lms-osz/wind/static/img/project/pi_installed_scaled.png

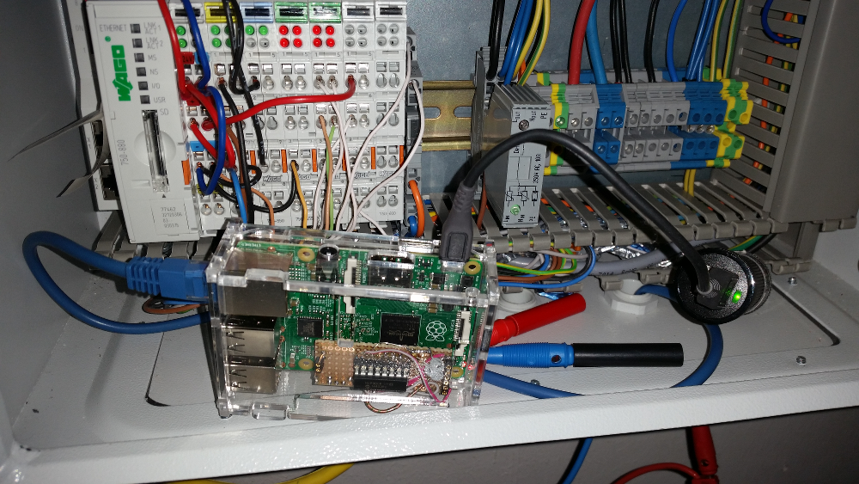
static/img/project/pi_installed_scaled.png
