lms-osz/wind/static/img/project/pi.png

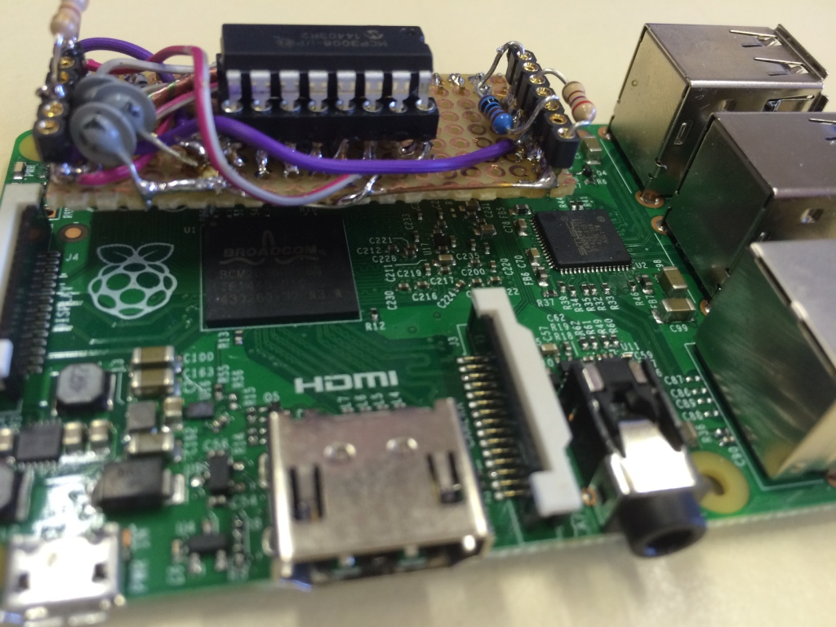
static/img/project/pi.png
