lms-osz/wind/schematics/README

Proudly made with KiCAD and the TinkerForge Libary:
https://github.com/Tinkerforge/kicad-libraries/blob/master/tinkerforge.lib
