lms-osz/wind/schematics/theorie.odt

A`=`1,0{m^2} ~~~~~~~~~~~~~%rho`=`1,205kg over m^{3} newline
C_Betz`=`{16 over 27}(ca. 60"%") ~~~~~~~~v`=`14{m over s} newline
P_{an~(Hersteller bei `14{m over s} )}`=` 250W ~
newline
P_ein `=` C_Betz {`cdot` {{1 over 2} `cdot` %rho `cdot` A `cdot` (v_wind)^{3}} overbrace
P_wind} newline P(14{m over s}) `=` {16 over 27}` cdot `{1 over 2}`cdot `1,205kg over m^{3} `cdot` 1,0{m^2} `cdot` (14{m over s})^{3} newline P(14{m over s})`=`{0,375 {kg over m}}`cdot` (14{m over s})^{3}`=` 979,6 W newline
%eta`=` P_an over P_ein `=` {250W} over {979,6 W} `=` 25,5"%"

Wirkungsgradberechnung

bei 14 m/s Windgeschwindigkeit und der Leistung 250W des Hersteller

Für die Berechnung des Wirkungsgrad braucht man die aktuelle Windgeschwindigkeit und aktuelle elektrische Leistung, welche sich aus der Stromstärke (I) und der Spannung (U) zusammensetzt.

Das Betz'sche Gesetz besagt, dass eine Windkraftanlage maximal 16/27 (knapp 60 Prozent) jener mechanischen Leistung, die der Wind ohne den bremsenden Rotor durch dessen Projektionsfläche transportiert, in Nutzleistung umwandeln kann. (von Wikipedia am 1.5.15 aufgerufen)

# Windkraftanlagen

Twister T 300

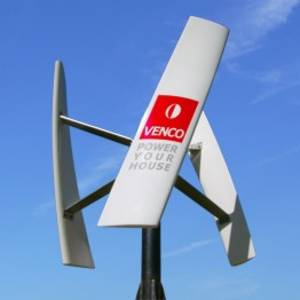
[picture p3: figure]

(http://www.fiber-tech.de/cms/index.php?eID=tx_cms_showpic&md5=b855fdd886baf51e2a2384f334ff9e43a7b020d7)

Der Twister T 300 wird eingesetzt von Instituten und öffentlichen Trägern, Forschungseinrichtungen sowie privaten Nutzern.

Der VENCO-Twister-300-T wurde so konzipiert, dass er bei einer Windgeschwindigkeit von ca. 3,0 m/s andreht. Ab einer Windgeschwindigkeit von 3,5 m/s wird Strom produziert. Durch seinen speziellen Aufbau arbeitet der VENCO-Twister-300-T absolut geräuschlos.

Seine Konstruktion ist robust und ohne verschleißende Bauteile. Er ist wartungsfrei und arbeitet auch unter extremen Bedingungen zuverlässig.

Das Gewicht mit Minimast beträgt ca. 52kg.

Technische Daten Rotor

Rotortyp | Vertikalachsen-Rotor
Nennleistung | 300W
Nennwindgeschwindigkeit | 14 m/s
max. Leistung | 250W (300 W)
Einschaltgeschwindigkeit | 3,5 m/s
Abschaltgeschwindigkeit | 25 m/S
Windnachführung | nicht erforderlich
Drehzahlregelung | elektronisch
Überlebenswindgeschwindigkeit | 50 m/s
Rotordurchmesser | 1,0 m
Blatthöhe | 1,0 m
überstrichene Fläche | 1,0 m²
Getriebetyp | getriebelos
Bremsanlagen | Generatorkurzschluss

Generator

Generatortyp | 3 Phasen Synchrongenerator, permanenterregt
Spannung | 0 bis 70 V DC
Elektronik | Überdrehzahl- u. Sicherheitscontroller
Laderegler | 10 / 24 V max. Ladestrom 25 A

Material

Streben | Edelstahl
Generatorgehäuse | Edelstahl
Rotorblätter | Glasfaser- u. Kohlefaser-verstärkter Kunststoff
