lms-osz/wind/static/pdf/theory.pdf

## Wirkungsgradberechnung

bei 14 m/s Windgeschwindigkeit und der Leistung 250W des Hersteller

Für die Berechnung des Wirkungsgrad braucht man die aktuelle Windgeschwindigkeit und aktuelle elektrische Leistung, welche sich aus der Stromstärke (I) und der Spannung (U) zusammensetzt.

Das Betz'sche Gesetz besagt, dass eine Windkraftanlage maximal 16/27 (knapp 60 Prozent) jener mechanischen Leistung, die der Wind ohne den bremsenden Rotor durch dessen Projektionsfläche transportiert, in Nutzleistung umwandeln kann. (von Wikipedia am 1.5.15 aufgerufen)

A = 1,0m

2

# ρ = 1,205 kg

m

3

### CBetz

=

16
27

# (ca. 60%) v = 14 m s

P

### an (Hersteller bei 14 m

s

)

| = 250W

### Pein

### = CBetz⋅

1
2

# ⋅ρ⋅ A⋅(vwind )

⏞
3

Pwind

P(14 m
s

)=

16
27

⋅

1
2

⋅1,205 kg
m

3

⋅1,0m

2

⋅(14 m
s

)

3

P(14 m
s

) = 0,375 kg
m

⋅(14 m
s

)

3
= 979,6W

η =

### Pan

### Pein

=

250W
979,6W

= 25,5%

# Windkraftanlagen

Twister T 300

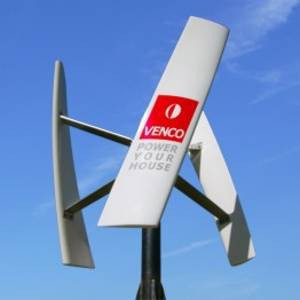
[picture p4: figure]

Der Twister T 300 wird eingesetzt von Instituten und öffentlichen Trägern,
Forschungseinrichtungen sowie privaten Nutzern.
Der VENCO-Twister-300-T wurde so konzipiert, dass er bei einer Windgeschwindigkeit von ca. 3,0 m/s andreht. Ab einer Windgeschwindigkeit von 3,5 m/s wird Strom produziert. Durch seinen speziellen Aufbau arbeitet der VENCO-Twister-300-T absolut geräuschlos.
Seine Konstruktion ist robust und ohne verschleißende Bauteile. Er ist wartungsfrei und arbeitet auch unter extremen Bedingungen zuverlässig.
Das Gewicht mit Minimast beträgt ca. 52kg.

Technische Daten Rotor

Rotortyp | Vertikalachsen-Rotor
Nennleistung | 300W
Nennwindgeschwindigkeit | 14 m/s
max. Leistung | 250W (300 W)
Einschaltgeschwindigkeit | 3,5 m/s
Abschaltgeschwindigkeit | 25 m/S
Windnachführung | nicht erforderlich
Drehzahlregelung | elektronisch
Überlebenswindgeschwindigkei | 50 m/s
Rotordurchmesser | 1,0 m
Blatthöhe | 1,0 m
überstrichene Fläche | 1,0 m²
Getriebetyp | getriebelos
Bremsanlagen | Generatorkurzschluss

Generator

Generatortyp | 3 Phasen Synchrongenerator, permanenterregt
Spannung | 0 bis 70 V DC
Elektronik | Überdrehzahl- u. Sicherheitscontroller
Laderegler | 10 / 24 V max. Ladestrom 25 A

Material

Streben | Edelstahl
Generatorgehäuse | Edelstahl
Rotorblätter | Glasfaser- u. Kohlefaser-verstärkter Kunststoff
