lms-osz/wind/static/img/project/all_scaled.png

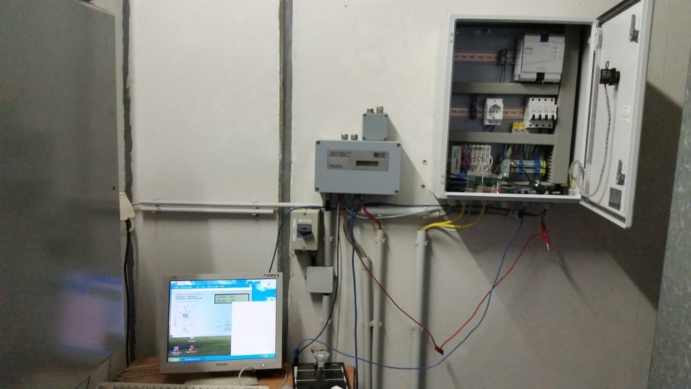
static/img/project/all_scaled.png
