lms-osz/wind/static/img/project/ammeter_scaled.png

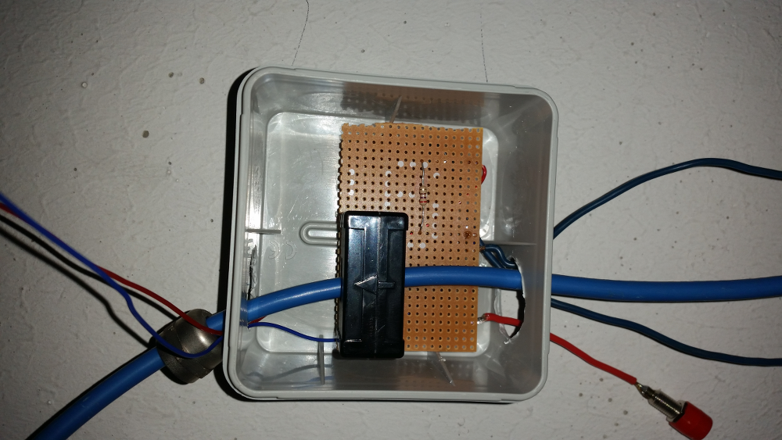
static/img/project/ammeter_scaled.png
