lms-osz/wind/static/img/project/pi_scaled.png

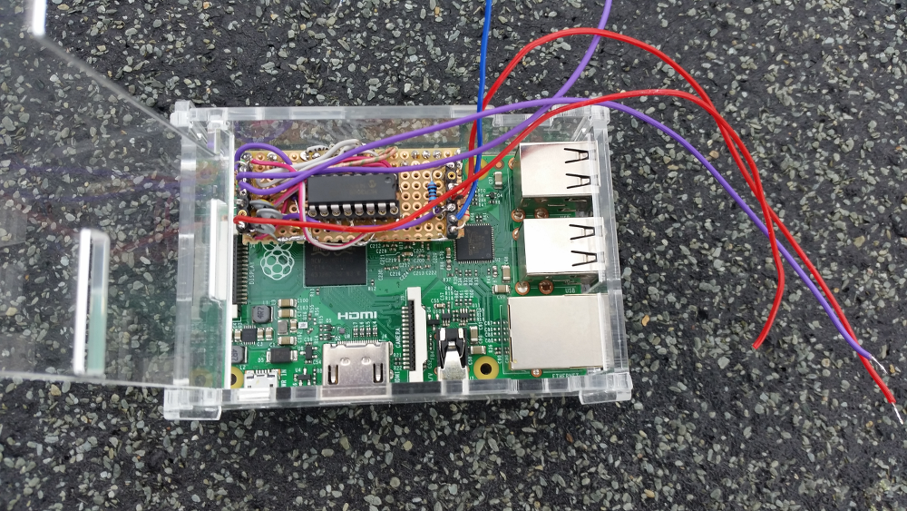
static/img/project/pi_scaled.png
