lms-osz/wind/static/img/wind_LMS.png

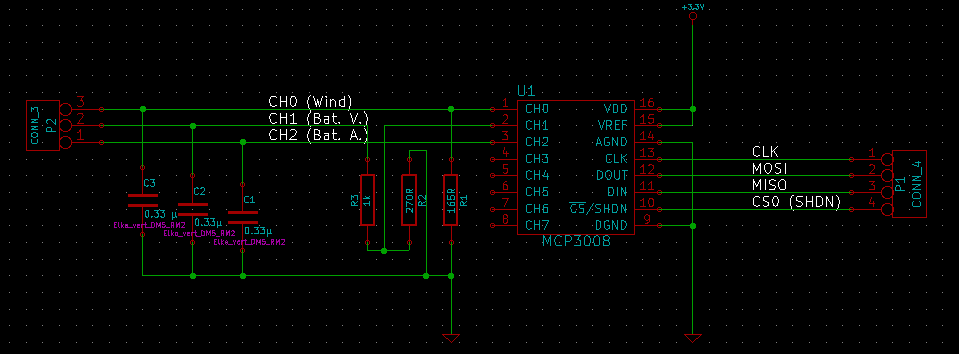
static/img/wind_LMS.png
