lms-osz/wind/schematics/wind_LMS.pdf

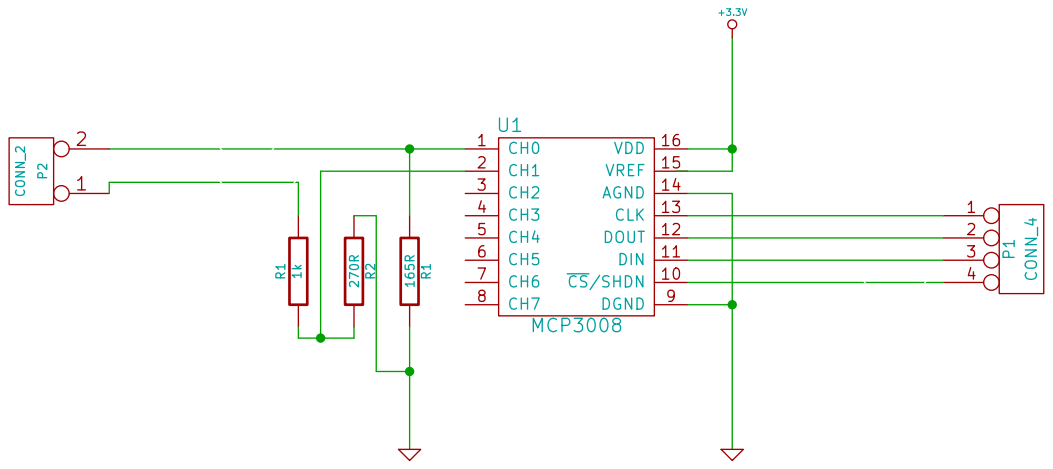
[picture p18: page 1]

Id: 1/1 Title: File: Wind_LMS.sch
Sheet: /
