lms-osz/wind/schematics/wind_LMS.sch

## KiCad design schematics/wind_LMS.sch (2015-04-09)

Schematic: wind_LMS.sch

Parts:
P1: CONN_4
P2: CONN_2
R1: 165R
R2: 270R
U1: MCP3008
