lms-osz/wind/(commit log)

2015-04-09 add schematics
    [Wind_LMS.sch]
2015-04-10 Name passte nicht wirklich
2015-04-10 Revert "Name passte nicht wirklich"
    This reverts commit 1943f94a7266451a80a47ecb7dec4ca50d3bdc5c.
2015-04-16 Update about.html
    meine Sachen angepasst und aus Entwikler Entwickler gemacht
2015-04-18 renamig files
    [wind_LMS.sch]
2015-04-20 changing loc of the wind-power
2015-04-30 adding start.sh and fix some errors
    [app.py]
2015-05-03 adding an table with voltage,... in index.html
2015-05-15 buggy chartgit add .!
    [app.py, config.py]
